mx-robotics/motor_control/README.md

moved to https://github.com/mx-car/motor_shield_teensy3.2
