mx-robotics/motor_control/hardware/RotaryEncoder/README.md

PCB for AMS (Austrian Micro Devices) Magnetic Position Sensors.

The physical interface fits the following devices:

1) AS5147P (https://ams.com/as5147p)

2) AS5047P (https://ams.com/as5047p)

3) AS5147 (https://ams.com/as5147)

4) AS5047D (https://ams.com/as5047d)
