mx-robotics/motor_control/hardware/RotaryEncoder/AS5147.brd

## EAGLE design hardware/RotaryEncoder/AS5147.brd (2019-05-07)

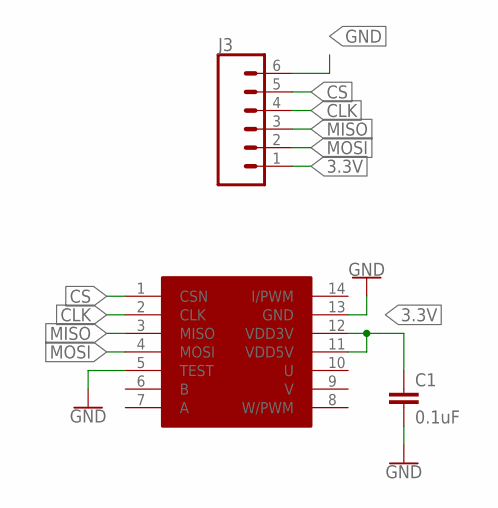
[picture p1: schematic AS5147.sch]

Parts:
C1: 0.1uF; 0603
J3: CONN_06SMD-1MM; 1X06-1MM
U$1: AS5147; TSSOP14

Connections:
3.3V: C1.1, J3.1, U$1.11 (VDD5V), U$1.12 (VDD3V)
CLK: J3.4, U$1.2 (CLK)
CS: J3.5, U$1.1 (CSN)
GND: C1.2, J3.6, U$1.5 (TEST), U$1.13 (GND)
MISO: J3.3, U$1.3 (MISO)
MOSI: J3.2, U$1.4 (MOSI)

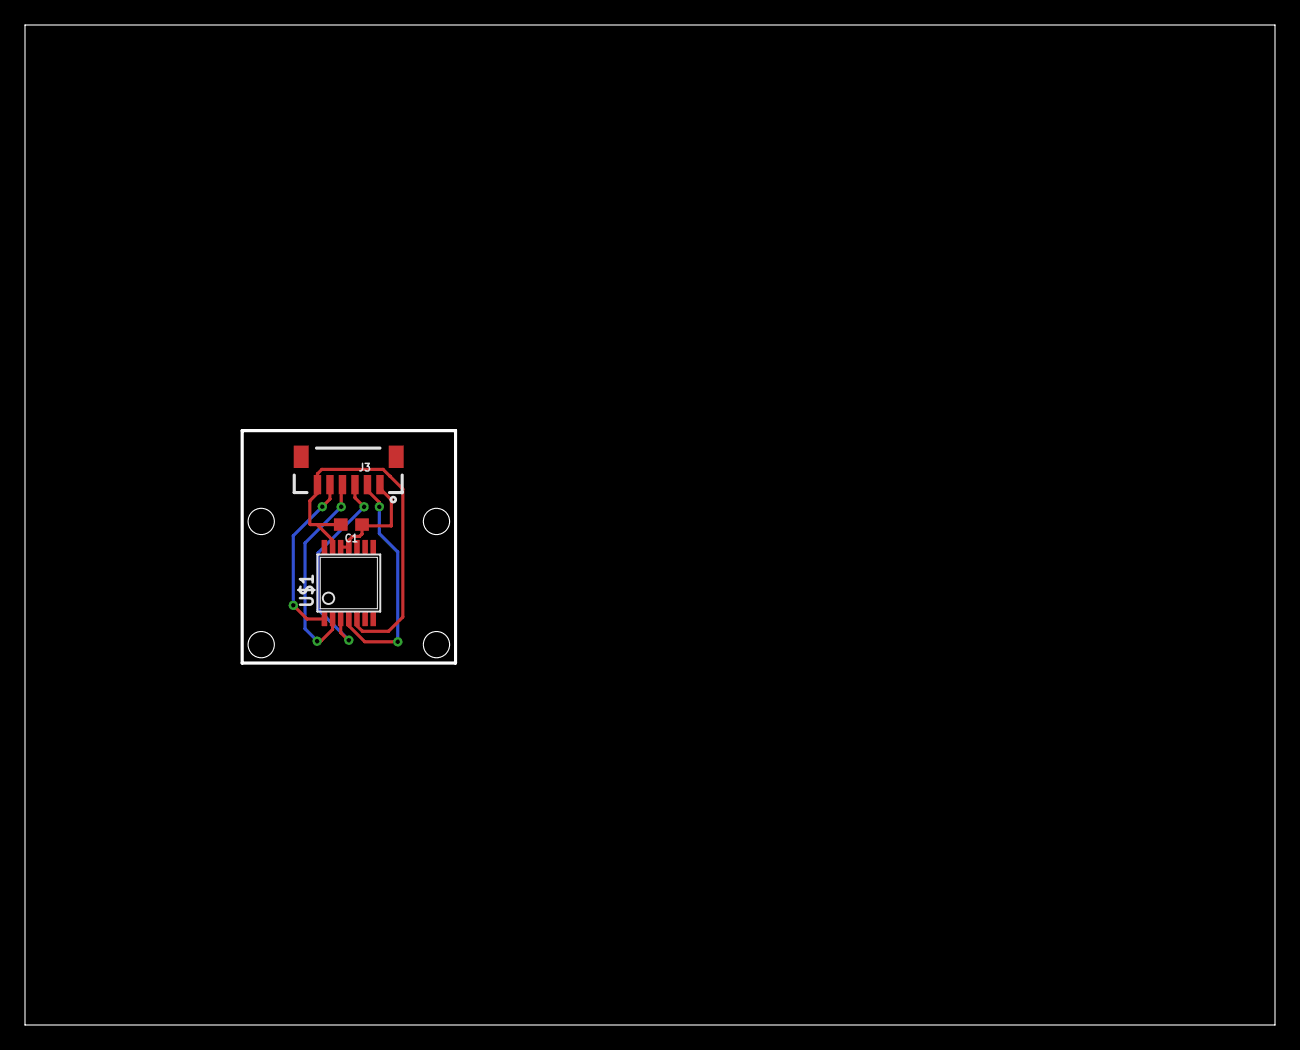
[picture p2: board AS5147.brd from above]

Board: 2 copper layers, 100.0 x 80.0 mm, 3 parts (0 on the bottom side), 6 nets.
