mx-robotics/motor_control/hardware/2MotorShield/2MS.brd

## EAGLE design hardware/2MotorShield/2MS.brd (2019-05-07)

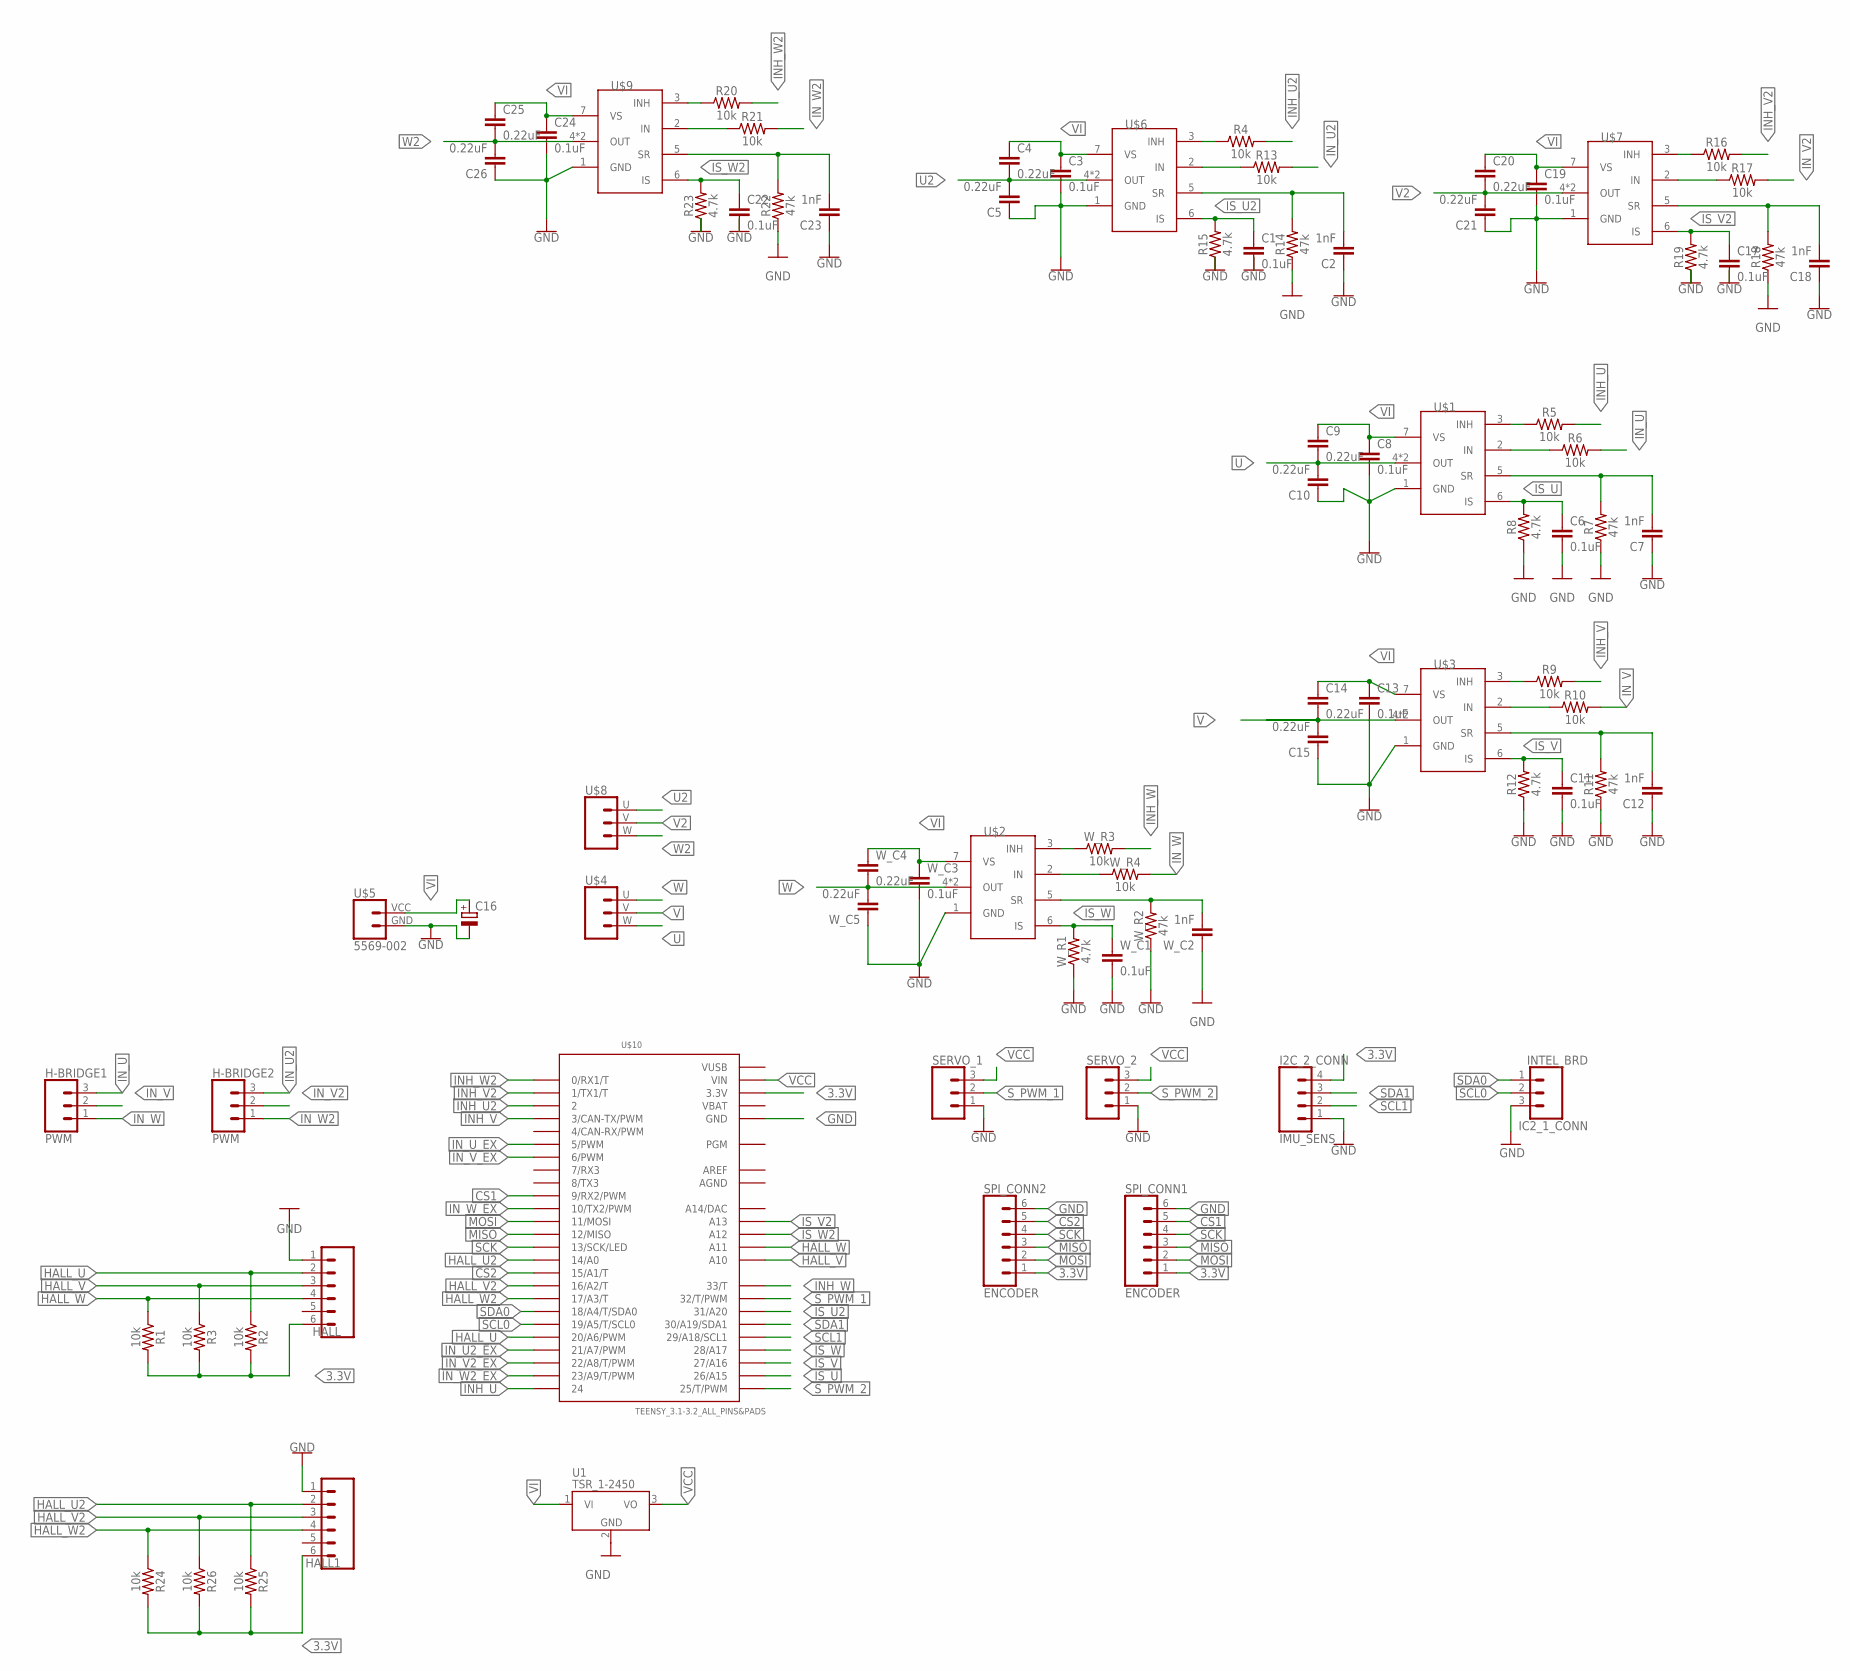
[picture p3: schematic 2MS.sch]

Parts:
C1, C3, C6, C8, C11, C13, C17, C19, C22, C24: 0.1uF; 0603
C2, C7, C12, C18, C23: 1nF; 0603
C4, C5, C9, C10, C14, C15, C20, C21, C25, C26: 0.22uF; 0603
C16: CPOL-EUE2,5-6E; E2,5-6E
H-BRIDGE1, H-BRIDGE2: PWM; 1X03_NO_SILK
HALL, HALL1: CONN_06SMD-1MM; 1X06-1MM
I2C_2_CONN: IMU_SENS; 1X04_NO_SILK
IC2_1_CONN: INTEL_BRD; 1X03_NO_SILK
R1, R2, R3, R4, R5, R6, R9, R10, R13, R16, R17, R20, R21, R24, R25, R26: 10k; 0603
R7, R11, R14, R18, R22: 47k; 0603
R8, R12, R15, R19, R23: 4.7k; 0603
SERVO_1, SERVO_2: CONN_031X03_NO_SILK; 1X03_NO_SILK
SPI_CONN1, SPI_CONN2: ENCODER; 1X06-1MM
U1: TSR_1-2450; TSR-1
U$1, U$2, U$3, U$6, U$7, U$9: IFX007TZZZZ; P-TO263-7-1
U$4, U$8: 5569-003
U$5: 5569-002
U$10: TEENSY_3.1-3.2_ALL_PINS&PADS; TEENSY_3.0-3.2_ALL_PINS_&_PADS
W_C1, W_C3: 0.1uF; 0603
W_C2: 1nF; 0603
W_C4, W_C5: 0.22uF; 0603
W_R1: 4.7k; 0603
W_R2: 47k; 0603
W_R3, W_R4: 10k; 0603

Connections:
3.3V: HALL.6, HALL1.6, I2C_2_CONN.4, R1.2, R2.2, R3.2, R24.2, R25.2, R26.2, SPI_CONN1.1, SPI_CONN2.1, U$10.3.3V, U$10.3.3V1 (3.3V), U$10.3.3V2 (3.3V)
AGND: U$10.AGND
AREF: U$10.AREF
CS1: SPI_CONN1.5, U$10.9 (9/RX2/PWM)
CS2: SPI_CONN2.5, U$10.15/A1 (15/A1/T)
GND: C1.2, C2.1, C3.2, C5.1, C6.2, C7.1, C8.2, C10.1, C11.2, C12.1, C13.2, C15.1, C16.-, C17.2, C18.1, C19.2, C21.1, C22.2, C23.1, C24.2, C26.1, HALL.1, HALL1.1, I2C_2_CONN.1, IC2_1_CONN.3, R7.1, R8.1, R11.1, R12.1, R14.1, R15.1, R18.1, R19.1, R22.1, R23.1, SERVO_1.1, SERVO_2.1, SPI_CONN1.6, SPI_CONN2.6, U1.2 (GND), U$1.1 (GND), U$2.1 (GND), U$3.1 (GND), U$5.GND (1), U$6.1 (GND), U$7.1 (GND), U$9.1 (GND), U$10.GND, U$10.GND1 (GND), U$10.GND2 (GND), W_C1.2, W_C2.1, W_C3.2, W_C5.1, W_R1.1, W_R2.1
HALL_U: HALL.2, R2.1, U$10.20/A6 (20/A6/PWM)
HALL_U2: HALL1.2, R25.1, U$10.14/A0
HALL_V: HALL.3, R3.1, U$10.A10
HALL_V2: HALL1.3, R26.1, U$10.16/A2 (16/A2/T)
HALL_W: HALL.4, R1.1, U$10.A11
HALL_W2: HALL1.4, R24.1, U$10.17/A3 (17/A3/T)
INH_U: R5.2, U$10.24
INH_U2: R4.2, U$10.2
INH_V: R9.2, U$10.3 (3/CAN-TX/PWM)
INH_V2: R16.2, U$10.1 (1/TX1/T)
INH_W: U$10.33 (33/T), W_R3.2
INH_W2: R20.2, U$10.0 (0/RX1/T)
IN_U: H-BRIDGE1.3, R6.2
IN_U2: H-BRIDGE2.3, R13.2
IN_U2_EX: U$10.21/A7 (21/A7/PWM)
IN_U_EX: U$10.5 (5/PWM)
IN_V: H-BRIDGE1.2, R10.2
IN_V2: H-BRIDGE2.2, R17.2
IN_V2_EX: U$10.22/A8 (22/A8/T/PWM)
IN_V_EX: U$10.6 (6/PWM)
IN_W: H-BRIDGE1.1, W_R4.2
IN_W2: H-BRIDGE2.1, R21.2
IN_W2_EX: U$10.23/A9 (23/A9/T/PWM)
IN_W_EX: U$10.10 (10/TX2/PWM)
IS_U: C6.1, R8.2, U$1.6 (IS), U$10.26 (26/A15)
IS_U2: C1.1, R15.2, U$6.6 (IS), U$10.31 (31/A20)
IS_V: C11.1, R12.2, U$3.6 (IS), U$10.27 (27/A16)
IS_V2: C17.1, R19.2, U$7.6 (IS), U$10.A13
IS_W: U$2.6 (IS), U$10.28 (28/A17), W_C1.1, W_R1.2
IS_W2: C22.1, R23.2, U$9.6 (IS), U$10.A12
MISO: SPI_CONN1.3, SPI_CONN2.3, U$10.12 (12/MISO)
MOSI: SPI_CONN1.2, SPI_CONN2.2, U$10.11 (11/MOSI)
unnamed: U$2.3 (INH), W_R3.1
unnamed: C12.2, R11.2, U$3.5 (SR)
unnamed: U$2.5 (SR), W_C2.2, W_R2.2
unnamed: C7.2, R7.2, U$1.5 (SR)
unnamed: R5.1, U$1.3 (INH)
unnamed: R6.1, U$1.2 (IN)
unnamed: R4.1, U$6.3 (INH)
unnamed: R9.1, U$3.3 (INH)
unnamed: R13.1, U$6.2 (IN)
unnamed: U$2.2 (IN), W_R4.1
unnamed: C2.2, R14.2, U$6.5 (SR)
unnamed: R10.1, U$3.2 (IN)
unnamed: R16.1, U$7.3 (INH)
unnamed: R17.1, U$7.2 (IN)
unnamed: C18.2, R18.2, U$7.5 (SR)
unnamed: R20.1, U$9.3 (INH)
unnamed: R21.1, U$9.2 (IN)
unnamed: C23.2, R22.2, U$9.5 (SR)
SCK: SPI_CONN1.4, SPI_CONN2.4, U$10.13 (13/SCK/LED)
SCL0: IC2_1_CONN.2, U$10.19/A5 (19/A5/T/SCL0)
SCL1: I2C_2_CONN.2, U$10.29 (29/A18/SCL1)
SDA0: IC2_1_CONN.1, U$10.18/A4 (18/A4/T/SDA0)
SDA1: I2C_2_CONN.3, U$10.30 (30/A19/SDA1)
S_PWM_1: SERVO_1.2, U$10.32 (32/T/PWM)
S_PWM_2: SERVO_2.2, U$10.25 (25/T/PWM)
U: C9.2, C10.2, U$1.4 (OUT), U$1.8 (OUT), U$4.W (V)
U2: C4.2, C5.2, U$6.4 (OUT), U$6.8 (OUT), U$8.U (W)
V: C14.2, C15.2, U$3.4 (OUT), U$3.8 (OUT), U$4.V (U)
V2: C20.2, C21.2, U$7.4 (OUT), U$7.8 (OUT), U$8.V (U)
VBAT: U$10.VBAT
VCC: SERVO_1.3, SERVO_2.3, U1.3 (VO), U$10.VIN
VI: C3.1, C4.1, C8.1, C9.1, C13.1, C14.1, C16.+, C19.1, C20.1, C24.1, C25.1, U1.1 (VI), U$1.7 (VS), U$2.7 (VS), U$3.7 (VS), U$5.VCC (2), U$6.7 (VS), U$7.7 (VS), U$9.7 (VS), W_C3.1, W_C4.1
VUSB: U$10.VUSB
W: U$2.4 (OUT), U$2.8 (OUT), U$4.U (W), W_C4.2, W_C5.2
W2: C25.2, C26.2, U$8.W (V), U$9.4 (OUT), U$9.8 (OUT)

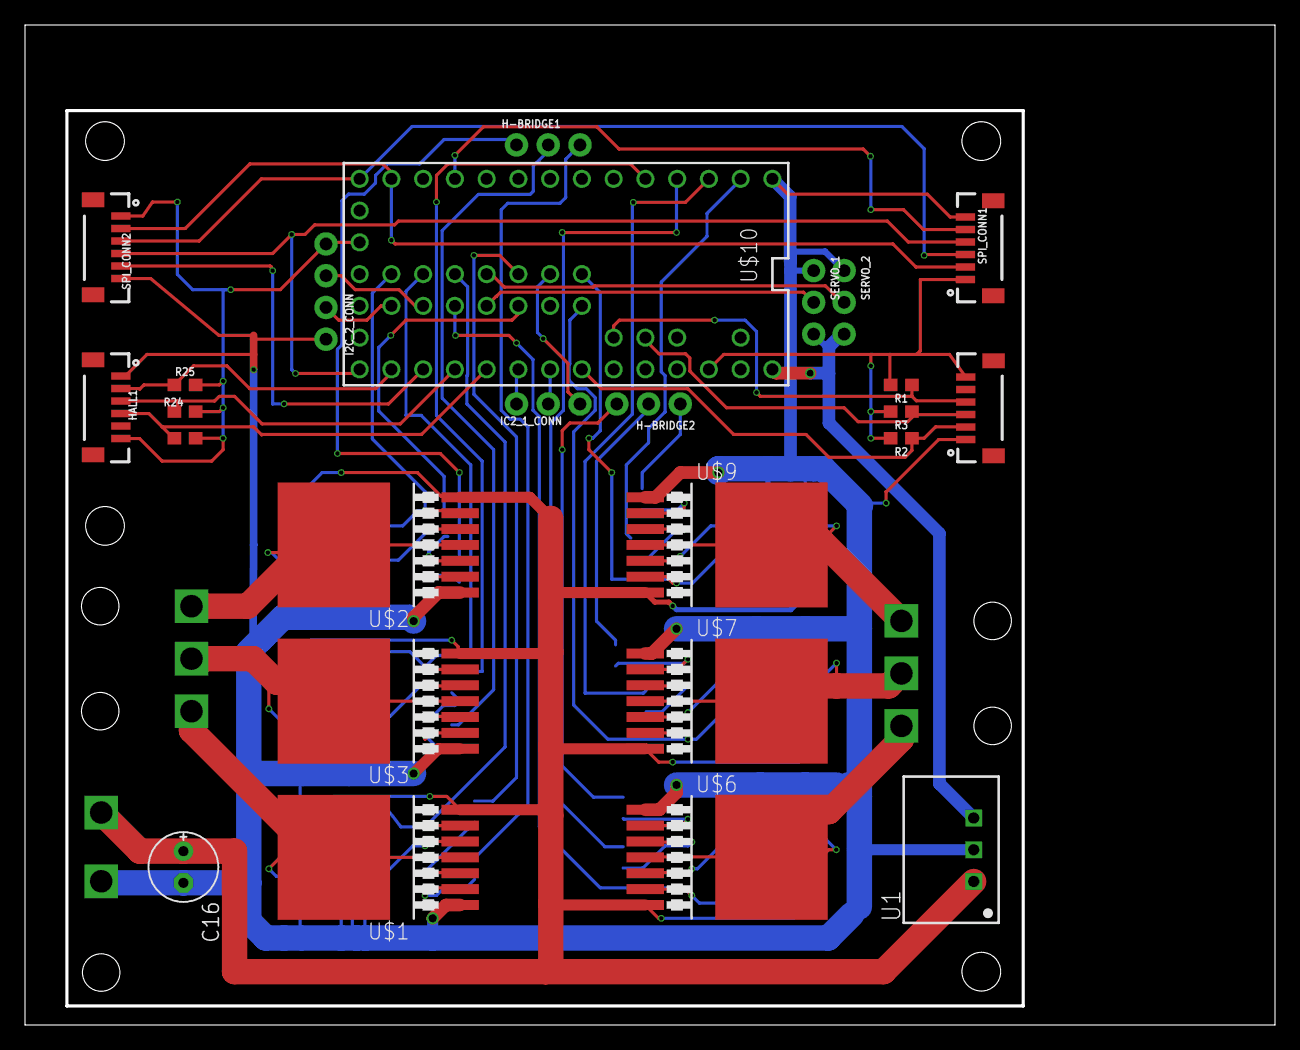
[picture p4: board 2MS.brd from above]

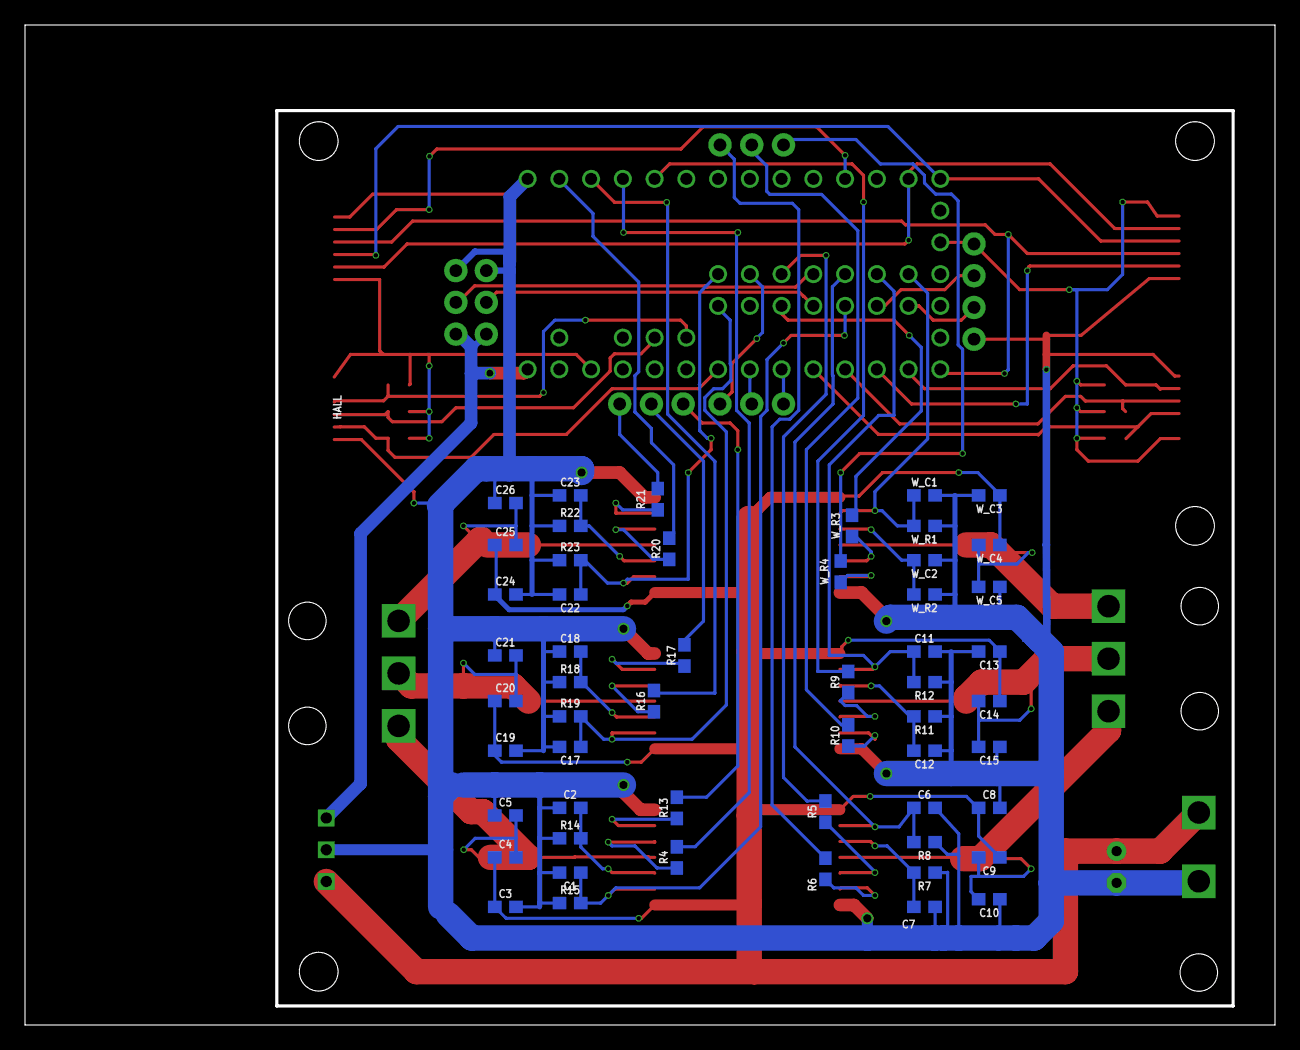
[picture p5: board 2MS.brd from below]

Board: 2 copper layers, 100.0 x 80.0 mm, 82 parts (55 on the bottom side), 63 nets.
