mx-robotics/motor_control/hardware/1MotorShield/1M_board.brd

## EAGLE design hardware/1MotorShield/1M_board.brd (2019-05-07)

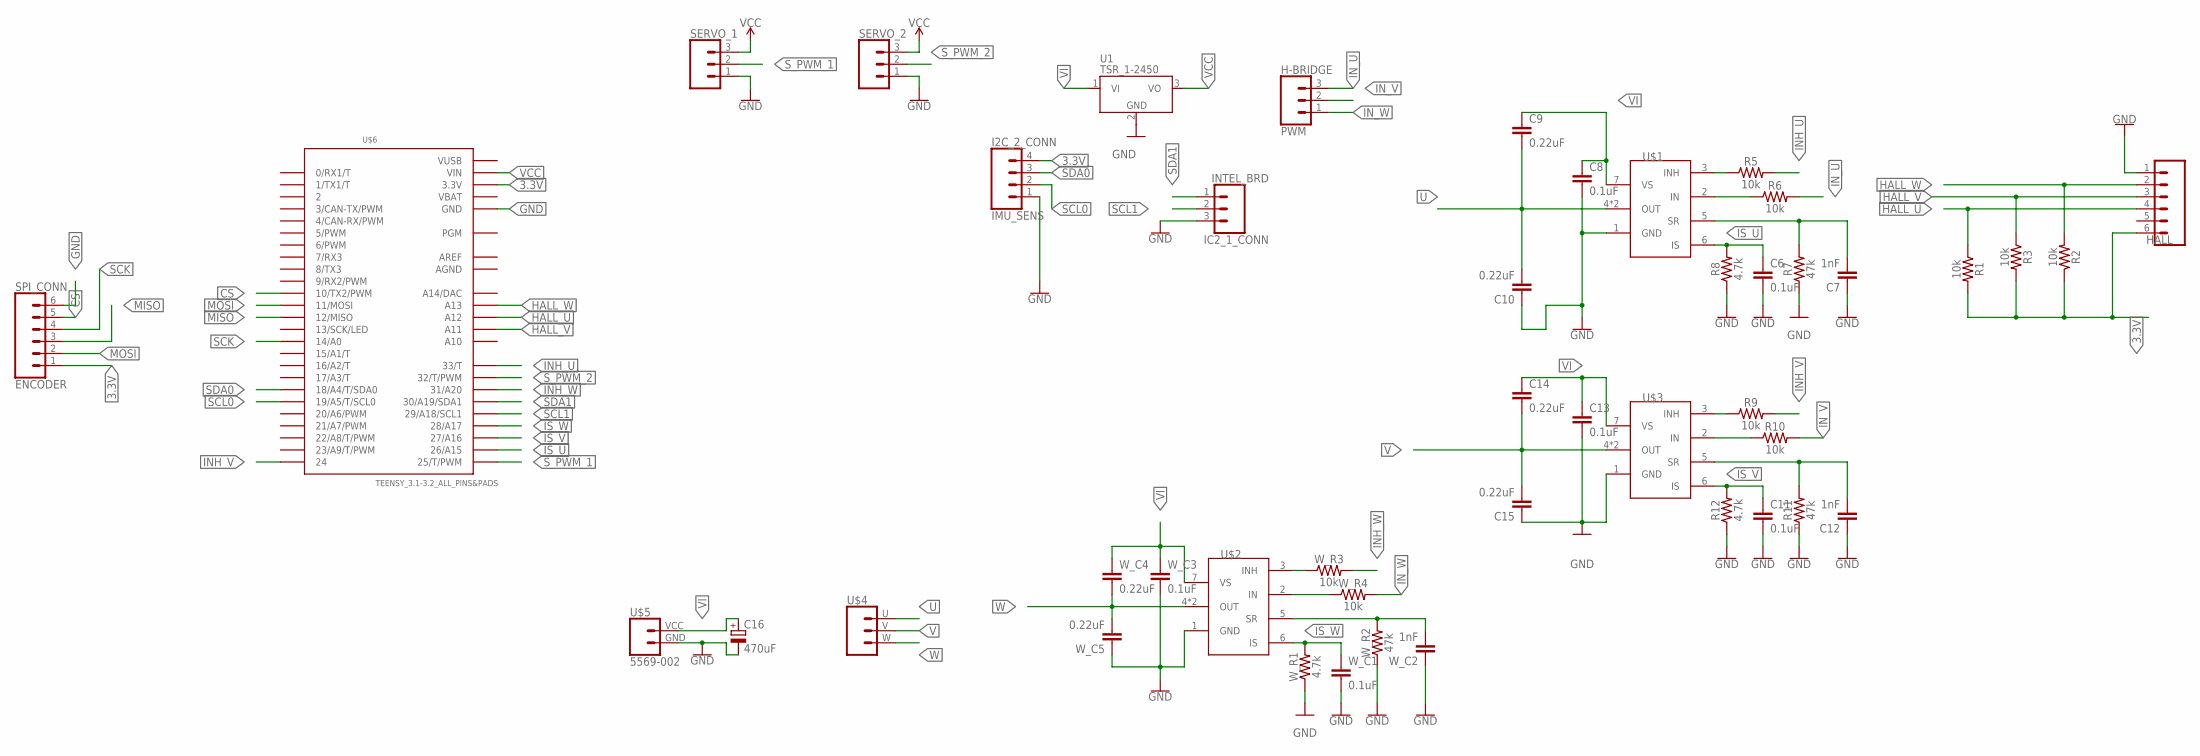
[picture p6: schematic 1M_board.sch]

Parts:
C6, C8, C11, C13: 0.1uF; 0603
C7, C12: 1nF; 0603
C9, C10, C14, C15: 0.22uF; 0603
C16: 470uF; E2,5-6E
H-BRIDGE: PWM; 1X03_NO_SILK
HALL: CONN_06SMD-1MM; 1X06-1MM
I2C_2_CONN: IMU_SENS; 1X04_NO_SILK
IC2_1_CONN: INTEL_BRD; 1X03_NO_SILK
R1, R2, R3, R5, R6, R9, R10: 10k; 0603
R7, R11: 47k; 0603
R8, R12: 4.7k; 0603
SERVO_1, SERVO_2: CONN_031X03_NO_SILK; 1X03_NO_SILK
SPI_CONN: ENCODER; 1X06-1MM
U1: TSR_1-2450; TSR-1
U$1, U$2, U$3: IFX007TZZZZ; P-TO263-7-1
U$4: 5569-003
U$5: 5569-002
U$6: TEENSY_3.1-3.2_ALL_PINS&PADS; TEENSY_3.0-3.2_ALL_PINS_&_PADS
W_C1, W_C3: 0.1uF; 0603
W_C2: 1nF; 0603
W_C4, W_C5: 0.22uF; 0603
W_R1: 4.7k; 0603
W_R2: 47k; 0603
W_R3, W_R4: 10k; 0603

Connections:
3.3V: HALL.6, I2C_2_CONN.4, R1.2, R2.1, R3.2, SPI_CONN.1, U$6.3.3V, U$6.3.3V1 (3.3V), U$6.3.3V2 (3.3V)
AGND: U$6.AGND
AREF: U$6.AREF
CS: SPI_CONN.5, U$6.10 (10/TX2/PWM)
GND: C6.2, C7.1, C8.2, C10.1, C11.2, C12.1, C13.2, C15.1, C16.-, HALL.1, I2C_2_CONN.1, IC2_1_CONN.3, R7.1, R8.1, R11.1, R12.1, SERVO_1.1, SERVO_2.1, SPI_CONN.6, U1.2 (GND), U$1.1 (GND), U$2.1 (GND), U$3.1 (GND), U$5.GND (1), U$6.GND, U$6.GND1 (GND), U$6.GND2 (GND), W_C1.2, W_C2.1, W_C3.2, W_C5.1, W_R1.1, W_R2.1
HALL_U: HALL.4, R1.1, U$6.A12
HALL_V: HALL.3, R3.1, U$6.A11
HALL_W: HALL.2, R2.2, U$6.A13
INH_U: R5.2, U$6.33 (33/T)
INH_V: R9.2, U$6.24
INH_W: U$6.31 (31/A20), W_R3.2
IN_U: H-BRIDGE.3, R6.2
IN_V: H-BRIDGE.2, R10.2
IN_W: H-BRIDGE.1, W_R4.2
IS_U: C6.1, R8.2, U$1.6 (IS), U$6.26 (26/A15)
IS_V: C11.1, R12.2, U$3.6 (IS), U$6.27 (27/A16)
IS_W: U$2.6 (IS), U$6.28 (28/A17), W_C1.1, W_R1.2
MISO: SPI_CONN.3, U$6.12 (12/MISO)
MOSI: SPI_CONN.2, U$6.11 (11/MOSI)
unnamed: U$2.3 (INH), W_R3.1
unnamed: C12.2, R11.2, U$3.5 (SR)
unnamed: U$2.5 (SR), W_C2.2, W_R2.2
unnamed: C7.2, R7.2, U$1.5 (SR)
unnamed: R5.1, U$1.3 (INH)
unnamed: R6.1, U$1.2 (IN)
unnamed: R9.1, U$3.3 (INH)
unnamed: U$2.2 (IN), W_R4.1
unnamed: R10.1, U$3.2 (IN)
SCK: SPI_CONN.4, U$6.14/A0
SCL0: I2C_2_CONN.2, U$6.19/A5 (19/A5/T/SCL0)
SCL1: IC2_1_CONN.2, U$6.29 (29/A18/SCL1)
SDA0: I2C_2_CONN.3, U$6.18/A4 (18/A4/T/SDA0)
SDA1: IC2_1_CONN.1, U$6.30 (30/A19/SDA1)
S_PWM_1: SERVO_1.2, U$6.25 (25/T/PWM)
S_PWM_2: SERVO_2.2, U$6.32 (32/T/PWM)
U: C9.2, C10.2, U$1.4 (OUT), U$1.8 (OUT), U$4.U (W)
V: C14.2, C15.2, U$3.4 (OUT), U$3.8 (OUT), U$4.V (U)
VBAT: U$6.VBAT
VCC: SERVO_1.3, SERVO_2.3, U1.3 (VO), U$6.VIN
VI: C8.1, C9.1, C13.1, C14.1, C16.+, U1.1 (VI), U$1.7 (VS), U$2.7 (VS), U$3.7 (VS), U$5.VCC (2), W_C3.1, W_C4.1
VUSB: U$6.VUSB
W: U$2.4 (OUT), U$2.8 (OUT), U$4.W (V), W_C4.2, W_C5.2

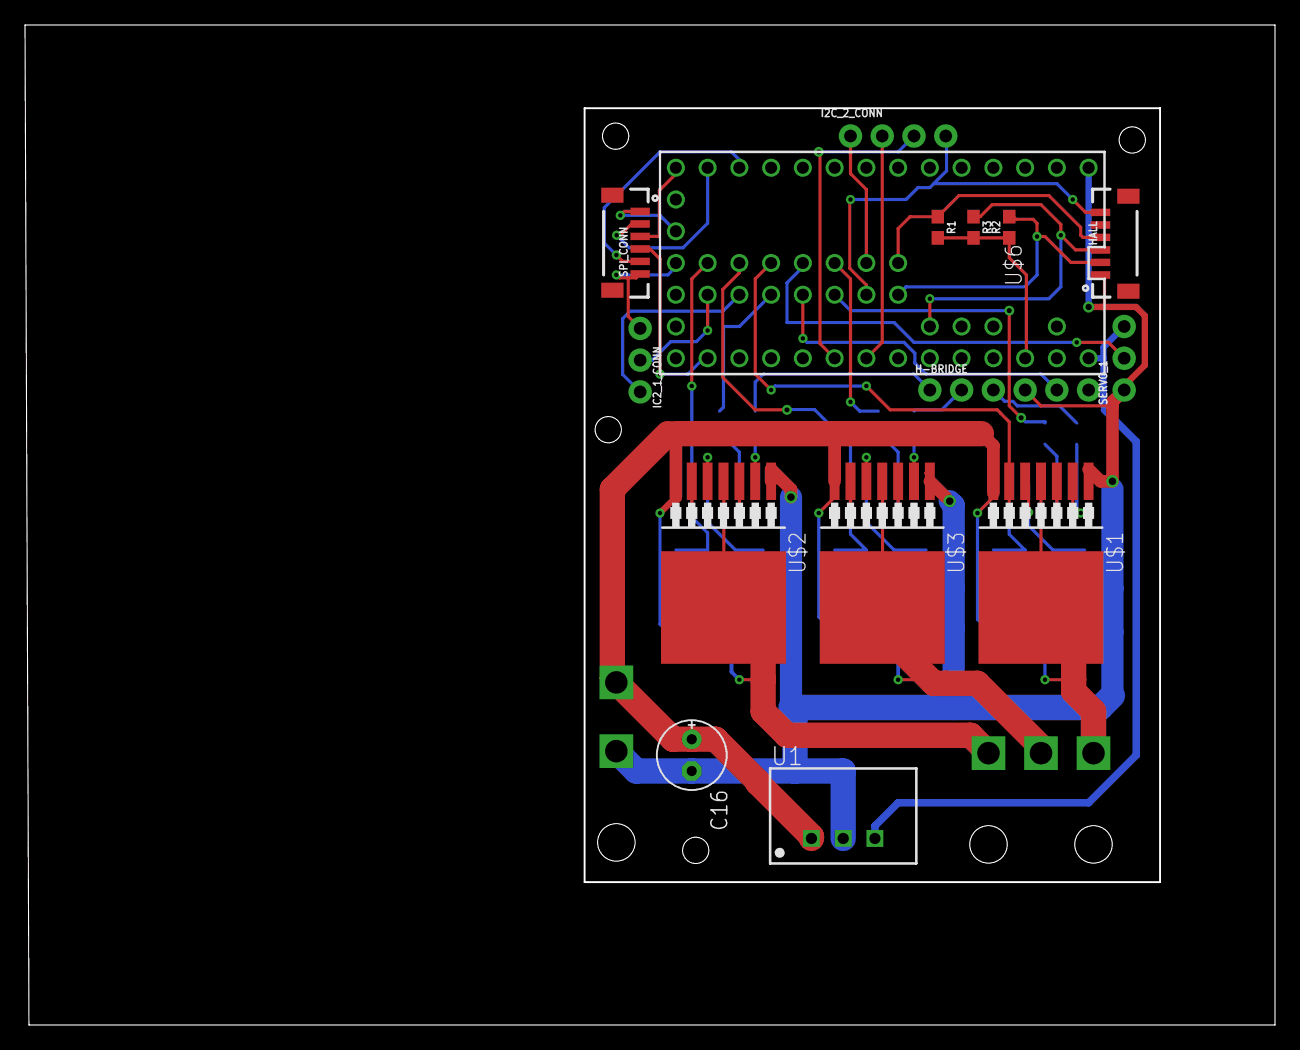
[picture p7: board 1M_board.brd from above]

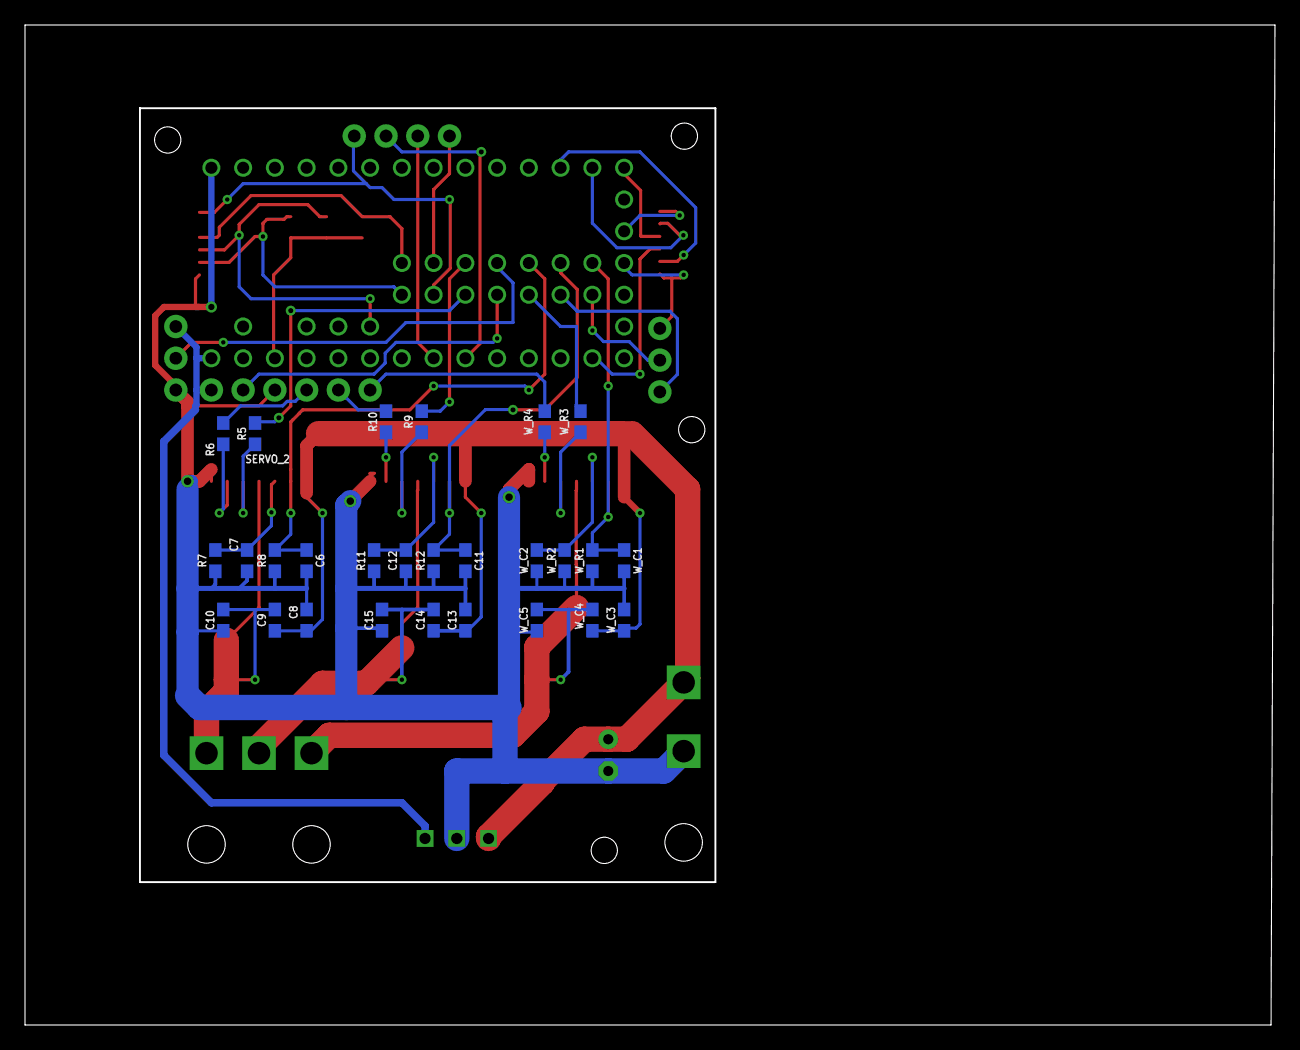
[picture p8: board 1M_board.brd from below]

Board: 2 copper layers, 100.0 x 80.0 mm, 45 parts (30 on the bottom side), 38 nets.
