mx-robotics/motor_control/Software/1Motor_refactor/include/SteeringServoController.h

//
// Created by firat on 21.01.20.
//

#ifndef INC_1MOTOR_REFACTOR_STEERINGSERVOCONTROLLER_H
#define INC_1MOTOR_REFACTOR_STEERINGSERVOCONTROLLER_H

#include "Motor.h"

class SteeringServoController {

    SteeringServoController( ServoPins servoPins ):servoPins(servoPins){}
    const ServoPins servoPins;
public:
    void controlSteeringServo(float_t angle); // not implemented yet, not necessary with diff drive



};


#endif //INC_1MOTOR_REFACTOR_STEERINGSERVOCONTROLLER_H
