mx-robotics/motor_control/Software/1Motor_refactor/src/PID.cpp

//
// Created by firat on 21.01.20.
//

#include "PID.h"
float SpeedPIDController::getSpeedCommand(Motor &motor, float targetSpeed){ // float might be a better valur for speed command

    float error = targetSpeed - motor.speedRPM; // error in rps

    kP = 0.5f;
    kI= 0.2f;
    kD = 0.1f;

    measurement_last = measurement_now;
    measurement_now = motor.speedRPM;

    error_sum += (error * kI);

    float proportional = (error * kP);
    float integral = error_sum; // here might be a problem
    float derivative = kD * ( measurement_now - measurement_last);

    if(integral > 9.9f){
        integral = 9.9f;
    }

    if(integral < -9.9f){
        integral = -9.9f;
    }

    acc_error = error_sum; // this was required for  plotting

    //get a command / speed curve
    float command =  (proportional + integral - derivative) * (11.22f - 0.22f*fabs(targetSpeed));
    if(command > 0){
        if (command > 99) { command = 99; }
        //motor.direction = 1;
        //if (command < 5) { command = 5; }
    }
    else{
        if(command < -99){ command = -99; }
        //direction = -1;

    }
    return abs(command);

    //command < 0 ? direction = -1 : direction = 1;



}
