mx-robotics/motor_control/Software/1Motor_refactor/src/utils.cpp

//
// Created by firat on 25.01.20.
//

#include "utils.h"
uint16_t utils::plot_counter=0;

/*
 * @TODO : add a serial interface to send data for debugging
 * @TODO : -> plotting
 * @TODO : -> simple send -> wrap em up in a class
 *
 *
 *
 *
 *
 * */
