mx-robotics/motor_control/(commit log)

2019-05-07 pcb schematics
    [1M_board.brd, 1M_board.sch, 2MS.brd, 2MS.sch]
2019-05-07 pcbs added
    [AS5157.brd, AS5157.sch]
2020-01-18 a working version has been added for 1motor board
2020-01-30 SPI working
2020-01-31 PWM Duty cycle calculation development
2020-02-16 spinning with TOF interrupt
2020-02-19 pid boiler plate added, 2. motor seems to be physically unfit
